lucio-barbieri/ASIC-BOB/README.md

# ASIC-BOB

Break-out board for the RFID+ ASIC.

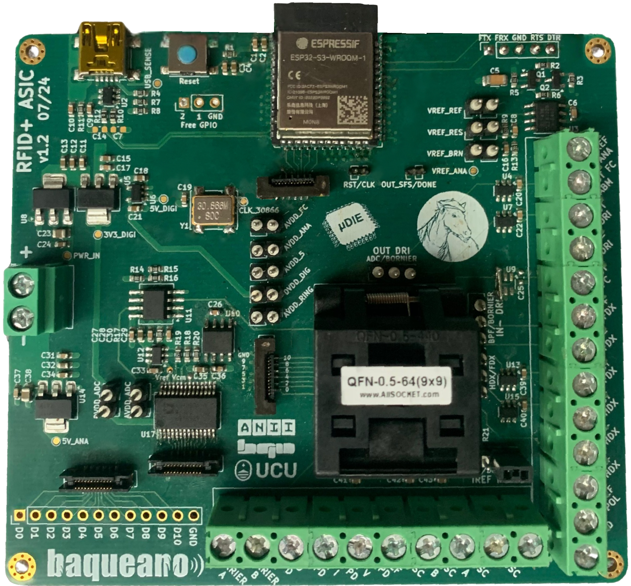
[picture p1: asic_bob.png]
ASIC BOB


---
