lucio-barbieri/ASIC-BOB/manufacturing/bom.csv

Designator | Footprint | Quantity | Value | LCSC Part #
C1, C12, C13, C15, C32, C34, C35 | 0603 | 7 | 10u
C10, C11, C16, C17, C19, C2, C20, C22, C24, C25, C26, C27, C29, C3, C30, C31, C33, C36, C37, C39, C40, C41, C42, C43, C6, C8, C9 | 0603 | 27 | 100n
C18, C21, C28, C4 | 0603 | 4 | 1u
C23, C38 | 0805 | 2 | 47u
C5 | 1206 | 1 | 10u
J10 | 117347422 | 1 | ADC side
J11 | 117347422 | 1 | User side
J12 | TerminalBlock_Phoenix_MKDS-1,5-10-5.08_1x10_P5.08mm_Horizontal | 1 | Outside interface
J13 | PinHeader_1x12_P2.54mm_Vertical | 1 | User side pinout
J2 | USB_Mini-B_Lumberg_2486_01_Horizontal | 1 | USB_B_Mini
J4 | PinHeader_1x02_P1.27mm_Vertical | 1 | OUT_SFS/DONE
J5 | PinHeader_1x02_P1.27mm_Vertical | 1 | RST/CLK
J6 | 117347422 | 1 | MCU side
J7 | TerminalBlock_Phoenix_MKDS-1,5-2_1x02_P5.00mm_Horizontal | 1 | Batt
J8 | TerminalBlock_Phoenix_MKDS-1,5-13-5.08_1x13_P5.08mm_Horizontal | 1 | Outside interface
J9 | 117347422 | 1 | ASIC side
Q1, Q2 | SOT-23 | 2 | 2SK2158
R1, R2, R3, R4, R5, R6, R7, R8 | 0603 | 8 | 10k
R10, R12 | 0603 | 2 | 0R
R11 | 0603 | 1 | 10
R13, R9 | 0603 | 2 | 220
R14, R15, R17, R18, R20 | 0603 | 5 | 1k
R16 | 0603 | 1 | 2k
R19 | 0603 | 1 | 1.5k
SW1 | SW_Push_1P1T_NO_6x6mm_H9.5mm | 1 | Reset
U1 | ESP32-S3-WROOM-1 | 1 | ESP32-S3-WROOM-1
U10, U3 | SOIC-8_3.9x4.9mm_P1.27mm | 2 | REF43
U11 | SO-8_5.3x6.2mm_P1.27mm | 1 | LT6231,
U12, U13, U15, U18, U19, U20, U4, U7, U9 | TSOT-23-6 | 9 | LT6230xS6
U14, U8 | SOT-223-3_TabPin2 | 2 | AMS1117-5.0
U17 | SSOP-28_5.3x10.2mm_P0.65mm | 1 | AD9200
U2 | SOT-23-6 | 1 | USBLC6-2SC6
U5 | SOT-223-3_TabPin2 | 1 | AMS1117-3.3
U6 | SOT-23-5 | 1 | MIC5504-1.8YM5
