lucio-barbieri/ASIC-BOB/manufacturing/JLCSMT_BOM.xlsx

Designator | Footprint | Quantity | Comment | LCSC Part # (optional)
C1, C12, C13, C15, C32, C34, C35 | 0603 | 7 | 10u | C19702
C10, C11, C16, C17, C19, C2, C20, C22, C24, C25, C26, C27, C29, C3, C30, C31, C33, C36, C37, C39, C40, C41, C42, C43, C6, C8, C9 | 0603 | 27 | 100n | C14663
C18, C21, C28, C4 | 0603 | 4 | 1u | C108463
C23, C38 | 0805 | 2 | 47u | C108659
C5 | 1206 | 1 | 10u | C13585
J12 | TerminalBlock_Phoenix_MKDS-1,5-10-5.08_1x10_P5.08mm_Horizontal | 1 | Outside interface
J2 | USB_Mini-B_Lumberg_2486_01_Horizontal | 1 | USB_B_Mini | C2681563
J4, J5 | PinHeader_1x02_P1.27mm_Vertical | 2 | OUT_SFS/DONE, RST/CLK | C2881948
J6, J9, J10, J11 | 117347422 | 4 | MCU side, ASIC side, ADC side, User side | C590853
J7 | TerminalBlock_Phoenix_MKDS-1,5-2_1x02_P5.00mm_Horizontal | 1 | Batt | C8404
J8 | TerminalBlock_Phoenix_MKDS-1,5-13-5.08_1x13_P5.08mm_Horizontal | 1 | Outside interface
Q1, Q2 | SOT-23 | 2 | 2SK2158 | C130894
R1, R2, R3, R4, R5, R6, R7, R8 | 0603 | 8 | 10k | C25804
R10, R12 | 0603 | 2 | 0R | C21189
R11 | 0603 | 1 | 10 | C22859
R13, R9 | 0603 | 2 | 220 | C22962
R14, R15, R17, R18, R20 | 0603 | 5 | 1k | C21190
R16 | 0603 | 1 | 2k | C22975
R19 | 0603 | 1 | 1.5k | C101276
SW1 | SW_Push_1P1T_NO_6x6mm_H9.5mm | 1 | Reset | C285446
U1 | ESP32-S3-WROOM-1 | 1 | ESP32-S3-WROOM-1 | C2913199
U10, U3 | SOIC-8_3.9x4.9mm_P1.27mm | 2 | REF43
U11 | SO-8_5.3x6.2mm_P1.27mm | 1 | LT6231 | C580237
U12, U13, U15, U18, U19, U20, U4, U7, U9 | TSOT-23-6 | 9 | LT6230xS6 | C580235
U14, U8 | SOT-223-3_TabPin2 | 2 | AMS1117-5.0 | C6187
U17 | SSOP-28_5.3x10.2mm_P0.65mm | 1 | AD9200 | C207693
U2 | SOT-23-6 | 1 | USBLC6-2SC6 | C2827654
U5 | SOT-223-3_TabPin2 | 1 | AMS1117-3.3 | C347222
U6 | SOT-23-5 | 1 | MIC5504-1.8YM5 | C626116
