lucio-barbieri/ASIC-BOB/socket.step

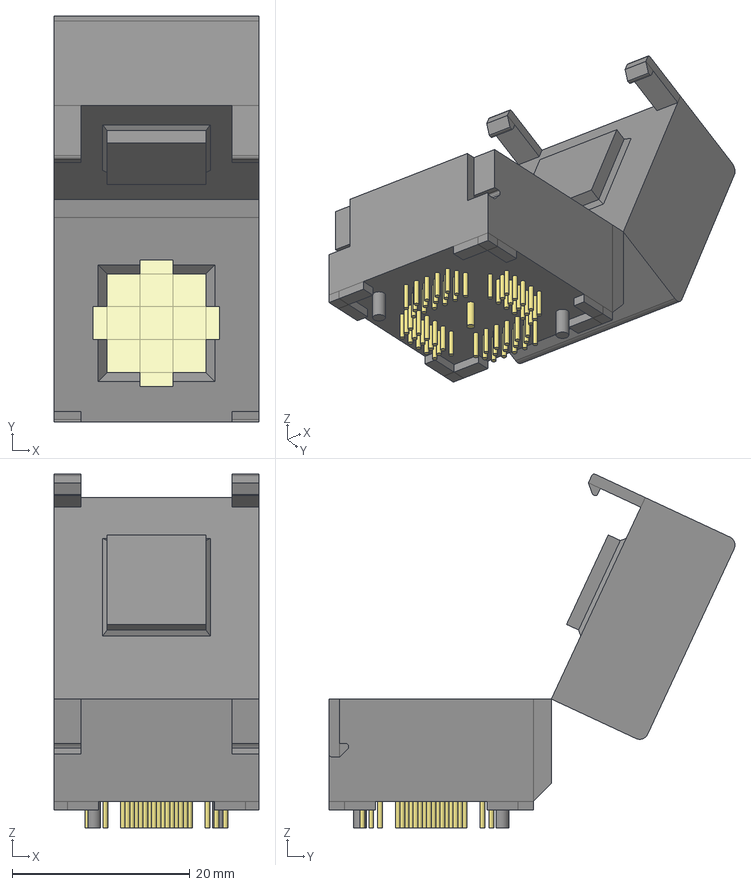
[picture p2: CAD file, 2024-06-28]
socket.step
23.0 x 45.7 x 39.8 mm
