lucio-barbieri/ASIC-BOB/(list of files, cad)

Other CAD files:
socket.FCStd
