lucio-barbieri/ASIC-BOB/asicBOB.kicad_pcb

## KiCad design asicBOB.kicad_pcb (2026-11-03)

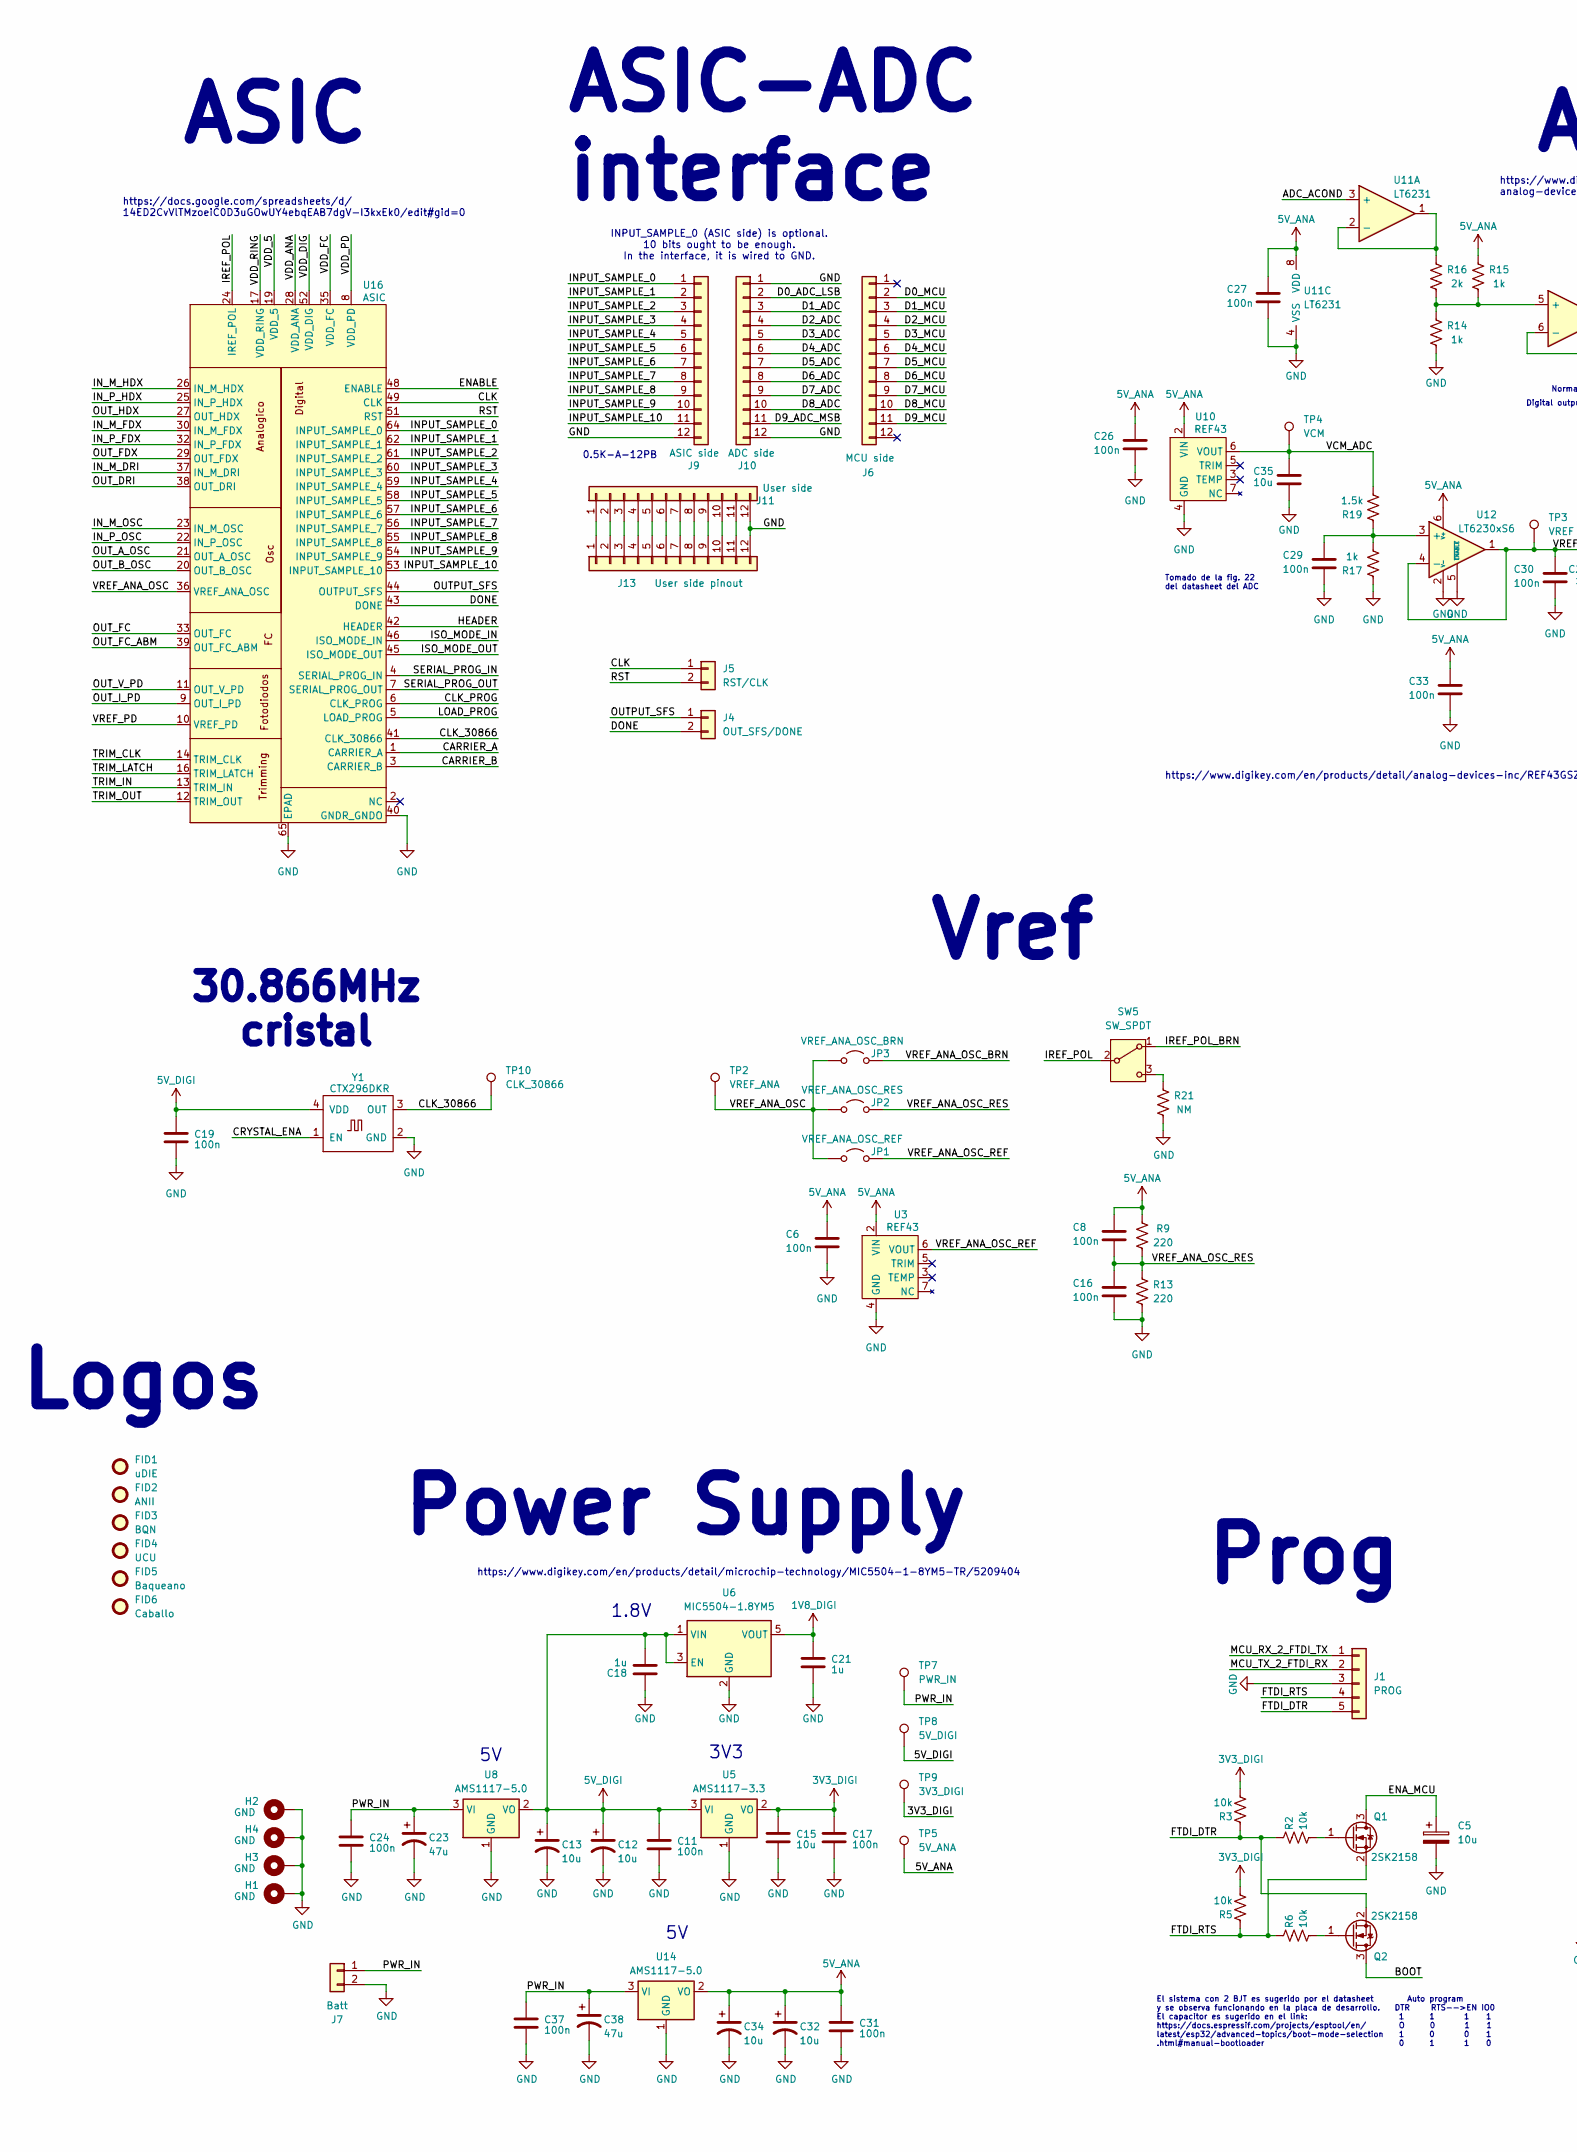
[picture p3: schematic asicBOB.kicad_sch, ASIC_BOB, part in row 1, column 1]

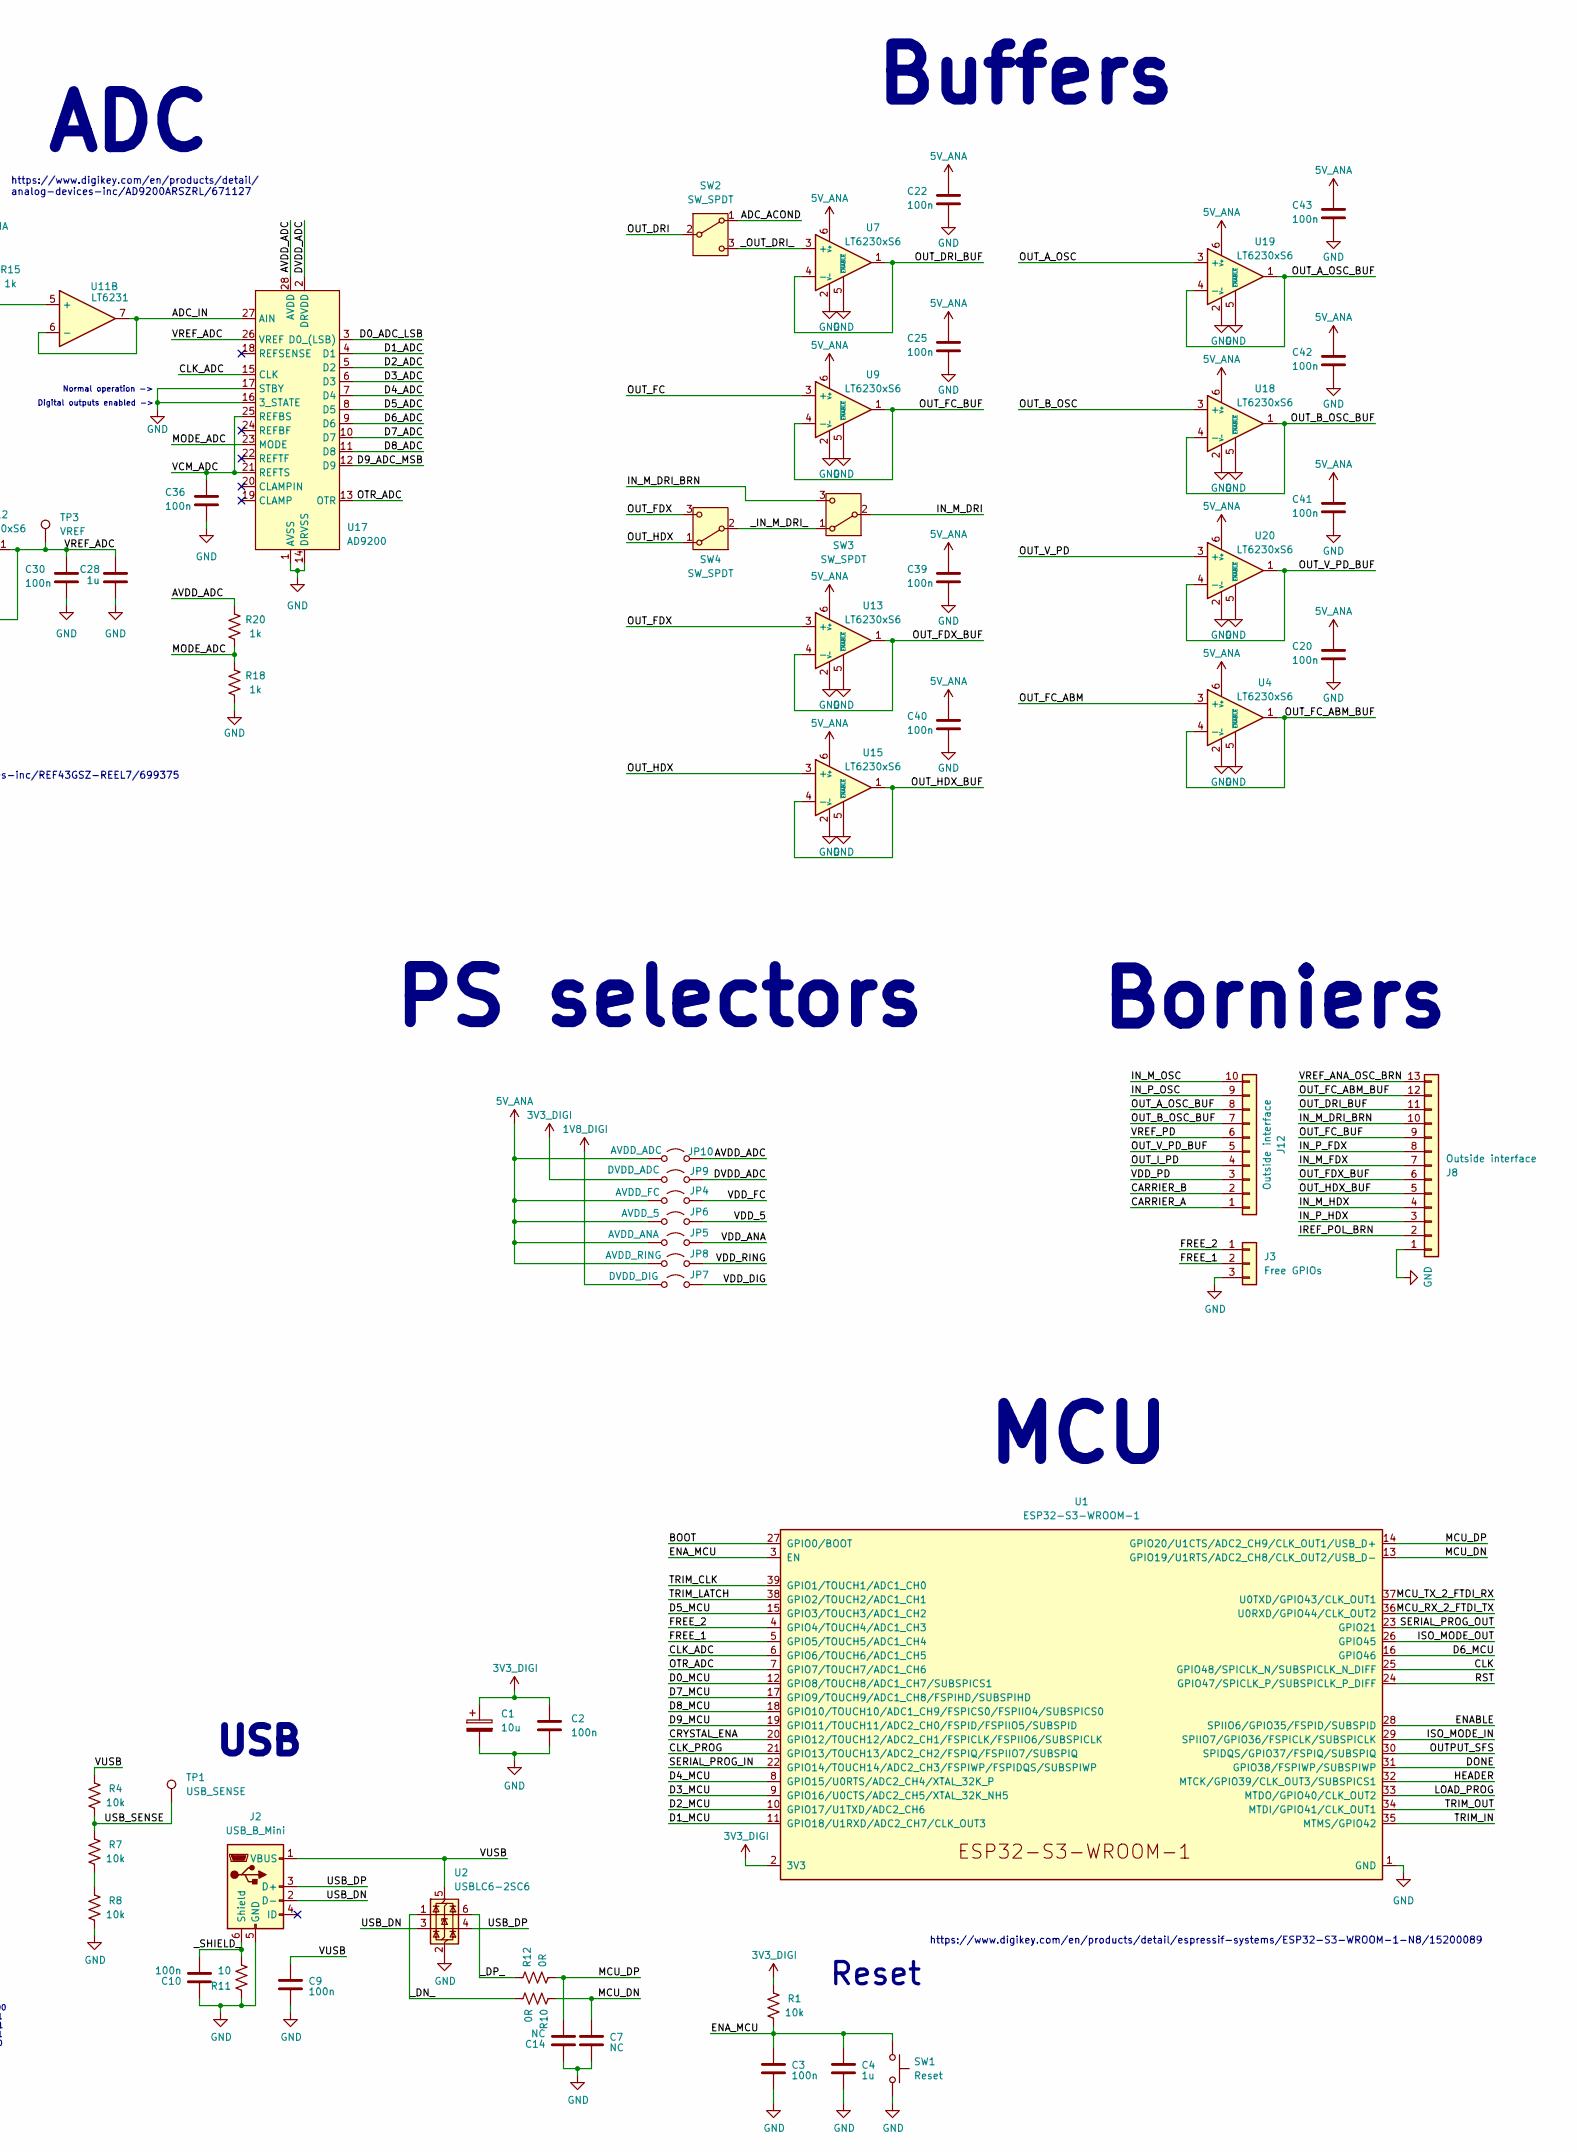
[picture p4: schematic asicBOB.kicad_sch, ASIC_BOB, part in row 1, column 2]

Parts:
C1, C12, C13, C15, C32, C34, C35: 10u; C_0603_1608Metric
C2, C3, C6, C8, C9, C10, C11, C16, C17, C19, C20, C22, C24, C25, C26, C27, C29, C30, C31, C33, C36, C37, C39, C40, C41, C42, C43: 100n; C_0603_1608Metric
C4, C18, C21, C28: 1u; C_0603_1608Metric
C5: 10u; C_1206_3216Metric
C7, C14: NC; C_0603_1608Metric
C23, C38: 47u; C_0805_2012Metric
FID1: uDIE; Logo_uDIE
FID2: ANII; Logo_ANII
FID3: BQN; Logo_BQN_12x4
FID4: UCU; Logo_UCU
FID5: Baqueano; Logo_baqueano_5x25
FID6: Caballo; Logo_caballoConBoina_15mm
H1, H2, H3, H4: GND; MountingHole_2.2mm_M2_Pad_Via
J1: PROG; PinSocket_1x05_P2.54mm_Vertical
J2: USB_B_Mini; USB_Mini-B_Lumberg_2486_01_Horizontal
J3: Free GPIOs; PinHeader_1x03_P2.54mm_Vertical
J4: OUT_SFS/DONE; PinHeader_1x02_P1.27mm_Vertical
J5: RST/CLK; PinHeader_1x02_P1.27mm_Vertical
J6: MCU side; 117347422
J7: Batt; TerminalBlock_Phoenix_MKDS-1,5-2_1x02_P5.00mm_Horizontal
J8: Outside interface; TerminalBlock_Phoenix_MKDS-1,5-13-5.08_1x13_P5.08mm_Horizon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
J9: ASIC side; 117347422
J10: ADC side; 117347422
J11: User side; 117347422
J12: Outside interface; TerminalBlock_Phoenix_MKDS-1,5-10-5.08_1x10_P5.08mm_Horizon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
J13: User side pinout; PinHeader_1x12_P2.54mm_Vertical
JP1: VREF_ANA_OSC_REF; PinHeader_1x02_P2.54mm_Vertical
JP2: VREF_ANA_OSC_RES; PinHeader_1x02_P2.54mm_Vertical
JP3: VREF_ANA_OSC_BRN; PinHeader_1x02_P2.54mm_Vertical
JP4: AVDD_FC; PinHeader_1x02_P2.54mm_Vertical
JP5: AVDD_ANA; PinHeader_1x02_P2.54mm_Vertical
JP6: AVDD_5; PinHeader_1x02_P2.54mm_Vertical
JP7: DVDD_DIG; PinHeader_1x02_P2.54mm_Vertical
JP8: AVDD_RING; PinHeader_1x02_P2.54mm_Vertical
JP9: DVDD_ADC; PinHeader_1x02_P2.54mm_Vertical
JP10: AVDD_ADC; PinHeader_1x02_P2.54mm_Vertical
Q1, Q2: 2SK2158; SOT-23
R1, R2, R3, R4, R5, R6, R7, R8: 10k; R_0603_1608Metric
R9, R13: 220; R_0603_1608Metric
R10, R12: 0R; R_0603_1608Metric
R11: 10; R_0603_1608Metric
R14, R15, R17, R18, R20: 1k; R_0603_1608Metric
R16: 2k; R_0603_1608Metric
R19: 1.5k; R_0603_1608Metric
R21: NM; R_0603_1608Metric
SW1: Reset; SW_Push_1P1T_NO_6x6mm_H9.5mm
SW2, SW3, SW4, SW5: SW_SPDT; PinHeader_1x03_P2.54mm_Vertical
TP1: USB_SENSE; TestPoint_Pad_D1.0mm
TP2: VREF_ANA; TestPoint_Pad_D1.0mm
TP3: VREF; TestPoint_Pad_D1.0mm
TP4: VCM; TestPoint_Pad_D1.0mm
TP5: 5V_ANA; TestPoint_Pad_D1.0mm
TP7: PWR_IN; TestPoint_Pad_D1.0mm
TP8: 5V_DIGI; TestPoint_Pad_D1.0mm
TP9: 3V3_DIGI; TestPoint_Pad_D1.0mm
TP10: CLK_30866; TestPoint_Pad_D1.0mm
U1: ESP32-S3-WROOM-1
U2: USBLC6-2SC6; SOT-23-6
U3, U10: REF43; SOIC-8_3.9x4.9mm_P1.27mm
U4, U7, U9, U12, U13, U15, U18, U19, U20: LT6230xS6; TSOT-23-6
U5: AMS1117-3.3; SOT-223-3_TabPin2
U6: MIC5504-1.8YM5; SOT-23-5
U8, U14: AMS1117-5.0; SOT-223-3_TabPin2
U11: LT6231; SO-8_5.3x6.2mm_P1.27mm
U16: ASIC; ASIC_RFID
U17: AD9200; SSOP-28_5.3x10.2mm_P0.65mm
Y1: CTX296DKR

Connections:
1V8_DIGI: C21.1, JP7.2 (B), U6.5 (VOUT)
3V3_DIGI: C1.1, C2.1, C15.1, C17.1, JP9.2 (B), R1.2, R3.2, R5.2, TP9.1, U1.2 (3V3), U5.2 (VO)
5V_ANA: C6.2, C8.2, C20.2, C22.2, C25.2, C26.2, C27.2, C31.1, C32.1, C33.2, C34.1, C39.2, C40.2, C41.2, C42.2, C43.2, JP4.2 (B), JP5.2 (B), JP6.2 (B), JP8.2 (B), JP10.1 (A), R9.2, R15.2, TP5.1, U3.2 (VIN), U4.6 (V+), U7.6 (V+), U9.6 (V+), U10.2 (VIN), U11.8 (VDD), U12.6 (V+), U13.6 (V+), U14.2 (VO), U15.6 (V+), U18.6 (V+), U19.6 (V+), U20.6 (V+)
5V_DIGI: C11.1, C12.1, C13.1, C18.2, C19.1, TP8.1, U5.3 (VI), U6.1 (VIN), U6.3 (EN), U8.2 (VO), Y1.4 (VDD)
/ADC_ACOND: SW2.1 (A), U11.3 (+)
/ADC_IN: U11.6 (-), U11.7, U17.27 (AIN)
/AVDD_ADC: JP10.2 (B), R20.2, U17.28 (AVDD)
/BOOT: Q2.3 (D), U1.27 (GPIO0/BOOT)
/CARRIER_A: J12.1, U16.1 (CARRIER_A)
/CARRIER_B: J12.2, U16.3 (CARRIER_B)
/CLK: J5.1, U1.25 (GPIO48/SPICLK_N/SUBSPICLK_N_DIFF), U16.49 (CLK)
/CLK_30866: TP10.1, U16.41 (CLK_30866), Y1.3 (OUT)
/CLK_ADC: U1.6 (GPIO6/TOUCH6/ADC1_CH5), U17.15 (CLK)
/CLK_PROG: U1.21 (GPIO13/TOUCH13/ADC2_CH2/FSPIQ/FSPIIO7/S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), U16.6 (CLK_PROG)
/CRYSTAL_ENA: U1.20 (GPIO12/TOUCH12/ADC2_CH1/FSPICLK/FSPIIO6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), Y1.1 (EN)
/D0_ADC_LSB: J10.2, U17.3 (D0_(LSB))
/D0_MCU: J6.2, U1.12 (GPIO8/TOUCH8/ADC1_CH7/SUBSPICS1)
/D1_ADC: J10.3, U17.4 (D1)
/D1_MCU: J6.3, U1.11 (GPIO18/U1RXD/ADC2_CH7/CLK_OUT3)
/D2_ADC: J10.4, U17.5 (D2)
/D2_MCU: J6.4, U1.10 (GPIO17/U1TXD/ADC2_CH6)
/D3_ADC: J10.5, U17.6 (D3)
/D3_MCU: J6.5, U1.9 (GPIO16/U0CTS/ADC2_CH5/XTAL_32K_NH5)
/D4_ADC: J10.6, U17.7 (D4)
/D4_MCU: J6.6, U1.8 (GPIO15/U0RTS/ADC2_CH4/XTAL_32K_P)
/D5_ADC: J10.7, U17.8 (D5)
/D5_MCU: J6.7, U1.15 (GPIO3/TOUCH3/ADC1_CH2)
/D6_ADC: J10.8, U17.9 (D6)
/D6_MCU: J6.8, U1.16 (GPIO46)
/D7_ADC: J10.9, U17.10 (D7)
/D7_MCU: J6.9, U1.17 (GPIO9/TOUCH9/ADC1_CH8/FSPIHD/SUBSPIHD)
/D8_ADC: J10.10, U17.11 (D8)
/D8_MCU: J6.10, U1.18 (GPIO10/TOUCH10/ADC1_CH9/FSPICS0/FSPIIO4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)
/D9_ADC_MSB: J10.11, U17.12 (D9)
/D9_MCU: J6.11, U1.19 (GPIO11/TOUCH11/ADC2_CH0/FSPID/FSPIIO5/S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)
/DONE: J4.2, U1.31 (GPIO38/FSPIWP/SUBSPIWP), U16.43 (DONE)
/DVDD_ADC: JP9.1 (A), U17.2 (DRVDD)
/ENABLE: U1.28 (SPIIO6/GPIO35/FSPID/SUBSPID), U16.48 (ENABLE)
/ENA_MCU: C3.1, C4.1, C5.1, Q1.3 (D), R1.1, SW1.1, U1.3 (EN)
/FREE_1: J3.2, U1.5 (GPIO5/TOUCH5/ADC1_CH4)
/FREE_2: J3.1, U1.4 (GPIO4/TOUCH4/ADC1_CH3)
/FTDI_DTR: J1.5, Q2.2 (S), R2.1, R3.1
/FTDI_RTS: J1.4, Q1.2 (S), R5.1, R6.1
/HEADER: U1.32 (MTCK/GPIO39/CLK_OUT3/SUBSPICS1), U16.42 (HEADER)
/INPUT_SAMPLE_0: J9.1, U16.64 (INPUT_SAMPLE_0)
/INPUT_SAMPLE_1: J9.2, U16.62 (INPUT_SAMPLE_1)
/INPUT_SAMPLE_2: J9.3, U16.61 (INPUT_SAMPLE_2)
/INPUT_SAMPLE_3: J9.4, U16.60 (INPUT_SAMPLE_3)
/INPUT_SAMPLE_4: J9.5, U16.59 (INPUT_SAMPLE_4)
/INPUT_SAMPLE_5: J9.6, U16.58 (INPUT_SAMPLE_5)
/INPUT_SAMPLE_6: J9.7, U16.57 (INPUT_SAMPLE_6)
/INPUT_SAMPLE_7: J9.8, U16.56 (INPUT_SAMPLE_7)
/INPUT_SAMPLE_8: J9.9, U16.55 (INPUT_SAMPLE_8)
/INPUT_SAMPLE_9: J9.10, U16.54 (INPUT_SAMPLE_9)
/INPUT_SAMPLE_10: J9.11, U16.53 (INPUT_SAMPLE_10)
/IN_M_DRI: SW3.2 (B), U16.37 (IN_M_DRI)
/IN_M_DRI_BRN: J8.10, SW3.3 (C)
/IN_M_FDX: J8.7, U16.30 (IN_M_FDX)
/IN_M_HDX: J8.4, U16.26 (IN_M_HDX)
/IN_M_OSC: J12.10, U16.23 (IN_M_OSC)
/IN_P_FDX: J8.8, U16.32 (IN_P_FDX)
/IN_P_HDX: J8.3, U16.25 (IN_P_HDX)
/IN_P_OSC: J12.9, U16.22 (IN_P_OSC)
/IREF_POL: SW5.2 (B), U16.24 (IREF_POL)
/IREF_POL_BRN: J8.2, SW5.1 (A)
/ISO_MODE_IN: U1.29 (SPIIO7/GPIO36/FSPICLK/SUBSPICLK), U16.46 (ISO_MODE_IN)
/ISO_MODE_OUT: U1.26 (GPIO45), U16.45 (ISO_MODE_OUT)
/LOAD_PROG: U1.33 (MTDO/GPIO40/CLK_OUT2), U16.5 (LOAD_PROG)
/MCU_DN: C7.1, R10.1, U1.13 (GPIO19/U1RTS/ADC2_CH8/CLK_OUT2/USB_D-)
/MCU_DP: C14.2, R12.2, U1.14 (GPIO20/U1CTS/ADC2_CH9/CLK_OUT1/USB_D+)
/MCU_RX_2_FTDI_TX: J1.1, U1.36 (U0RXD/GPIO44/CLK_OUT2)
/MCU_TX_2_FTDI_RX: J1.2, U1.37 (U0TXD/GPIO43/CLK_OUT1)
/MODE_ADC: R18.2, R20.1, U17.23 (MODE)
/OTR_ADC: U1.7 (GPIO7/TOUCH7/ADC1_CH6), U17.13 (OTR)
/OUTPUT_SFS: J4.1, U1.30 (SPIDQS/GPIO37/FSPIQ/SUBSPIQ), U16.44 (OUTPUT_SFS)
/OUT_A_OSC: U16.21 (OUT_A_OSC), U19.3 (+)
/OUT_A_OSC_BUF: J12.8, U19.1, U19.4 (-)
/OUT_B_OSC: U16.20 (OUT_B_OSC), U18.3 (+)
/OUT_B_OSC_BUF: J12.7, U18.1, U18.4 (-)
/OUT_DRI: SW2.2 (B), U16.38 (OUT_DRI)
/OUT_DRI_BUF: J8.11, U7.1, U7.4 (-)
/OUT_FC: U9.3 (+), U16.33 (OUT_FC)
/OUT_FC_ABM: U4.3 (+), U16.39 (OUT_FC_ABM)
/OUT_FC_ABM_BUF: J8.12, U4.1, U4.4 (-)
/OUT_FC_BUF: J8.9, U9.1, U9.4 (-)
/OUT_FDX: SW4.3 (C), U13.3 (+), U16.29 (OUT_FDX)
/OUT_FDX_BUF: J8.6, U13.1, U13.4 (-)
/OUT_HDX: SW4.1 (A), U15.3 (+), U16.27 (OUT_HDX)
/OUT_HDX_BUF: J8.5, U15.1, U15.4 (-)
/OUT_I_PD: J12.4, U16.9 (OUT_I_PD)
/OUT_V_PD: U16.11 (OUT_V_PD), U20.3 (+)
/OUT_V_PD_BUF: J12.5, U20.1, U20.4 (-)
/PWR_IN: C23.1, C24.1, C37.1, C38.1, J7.1, TP7.1, U8.3 (VI), U14.3 (VI)
/RST: J5.2, U1.24 (GPIO47/SPICLK_P/SUBSPICLK_P_DIFF), U16.51 (RST)
/SERIAL_PROG_IN: U1.22 (GPIO14/TOUCH14/ADC2_CH3/FSPIWP/FSPIDQS/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), U16.4 (SERIAL_PROG_IN)
/SERIAL_PROG_OUT: U1.23 (GPIO21), U16.7 (SERIAL_PROG_OUT)
/TRIM_CLK: U1.39 (GPIO1/TOUCH1/ADC1_CH0), U16.14 (TRIM_CLK)
/TRIM_IN: U1.35 (MTMS/GPIO42), U16.13 (TRIM_IN)
/TRIM_LATCH: U1.38 (GPIO2/TOUCH2/ADC1_CH1), U16.16 (TRIM_LATCH)
/TRIM_OUT: U1.34 (MTDI/GPIO41/CLK_OUT1), U16.12 (TRIM_OUT)
/USB_DN: J2.2 (D-), U2.3 (I/O2)
/USB_DP: J2.3 (D+), U2.4 (I/O2)
/USB_SENSE: R4.1, R7.2, TP1.1
/VCM_ADC: C35.2, C36.2, R19.1, TP4.1, U10.6 (VOUT), U17.21 (REFTS), U17.25 (REFBS)
/VDD_5: JP6.1 (A), U16.19 (VDD_5)
/VDD_ANA: JP5.1 (A), U16.28 (VDD_ANA)
/VDD_DIG: JP7.1 (A), U16.52 (VDD_DIG)
/VDD_FC: JP4.1 (A), U16.35 (VDD_FC)
/VDD_PD: J12.3, U16.8 (VDD_PD)
/VDD_RING: JP8.1 (A), U16.17 (VDD_RING)
/VREF_ADC: C28.2, C30.2, TP3.1, U12.1, U12.4 (-), U17.26 (VREF)
/VREF_ANA_OSC: JP1.1 (A), JP2.1 (A), JP3.1 (A), TP2.1, U16.36 (VREF_ANA_OSC)
/VREF_ANA_OSC_BRN: J8.13, JP3.2 (B)
/VREF_ANA_OSC_REF: JP1.2 (B), U3.6 (VOUT)
/VREF_ANA_OSC_RES: C8.1, C16.2, JP2.2 (B), R9.1, R13.2
/VREF_PD: J12.6, U16.10 (VREF_PD)
/VUSB: C9.1, J2.1 (VBUS), R4.2, U2.5 (VBUS)
/_DN_: R10.2, U2.1 (I/O1)
/_DP_: R12.1, U2.6 (I/O1)
/_IN_M_DRI_: SW3.1 (A), SW4.2 (B)
/_OUT_DRI_: SW2.3 (C), U7.3 (+)
/_SHIELD_: C10.2, J2.6 (Shield), R11.2
GND: C1.2, C2.2, C3.2, C4.2, C5.2, C6.1, C7.2, C9.2, C10.1, C11.2, C12.2, C13.2, C14.1, C15.2, C16.1, C17.2, C18.1, C19.2, C20.1, C21.2, C22.1, C23.2, C24.2, C25.1, C26.1, C27.1, C28.1, C29.1, C30.1, C31.2, C32.2, C33.1, C34.2, C35.1, C36.1, C37.2, C38.2, C39.1, C40.1, C41.1, C42.1, C43.1, H1.1, H2.1, H3.1, H4.1, J1.3, J2.5 (GND), J3.3, J7.2, J8.1, J9.12, J10.1, J10.12, J11.12, J13.12, R8.1, R11.1, R13.1, R14.1, R17.2, R18.1, R21.1, SW1.2, U1.1 (GND), U1.40 (GND), U1.41 (GND), U2.2 (GND), U3.4 (GND), U4.2 (V-), U4.5 (~ENABLE), U5.1 (GND), U6.2 (GND), U7.2 (V-), U7.5 (~ENABLE), U8.1 (GND), U9.2 (V-), U9.5 (~ENABLE), U10.4 (GND), U11.4 (VSS), U12.2 (V-), U12.5 (~ENABLE), U13.2 (V-), U13.5 (~ENABLE), U14.1 (GND), U15.2 (V-), U15.5 (~ENABLE), U16.40 (GNDR_GNDO), U16.65 (EPAD), U17.1 (AVSS), U17.14 (DRVSS), U17.16 (3_STATE), U17.17 (STBY), U18.2 (V-), U18.5 (~ENABLE), U19.2 (V-), U19.5 (~ENABLE), U20.2 (V-), U20.5 (~ENABLE), Y1.2 (GND)
unnamed: J11.1, J13.1
unnamed: J11.2, J13.2
unnamed: J11.3, J13.3
unnamed: J11.4, J13.4
unnamed: J11.5, J13.5
unnamed: J11.6, J13.6
unnamed: J11.7, J13.7
unnamed: J11.8, J13.8
unnamed: J11.9, J13.9
unnamed: J11.10, J13.10
unnamed: J11.11, J13.11
unnamed: Q1.1 (G), R2.2
unnamed: Q2.1 (G), R6.2
unnamed: R7.1, R8.2
unnamed: R21.2, SW5.3 (C)
unnamed: R16.2, U11.1, U11.2 (-)
unnamed: R14.2, R15.1, R16.1, U11.5 (+)
unnamed: C29.2, R17.1, R19.2, U12.3 (+)

Notes on the sheet:
0.5K-A-12PB
Logos
INPUT_SAMPLE_0 (ASIC side) is optional. 10 bits ought to be enough. In the interface, it is wired to GND.
ADC
ASIC-ADC interface
3V3
https://www.digikey.com/en/products/detail/analog-devices-inc/REF43GSZ-REEL7/699375
https://www.digikey.com/en/products/detail/microchip-technology/MIC5504-1-8YM5-TR/5209404
USB
https://www.digikey.com/en/products/detail/espressif-systems/ESP32-S3-WROOM-1-N8/15200089
Auto program DTR RTS-->EN IO0 1 1 1 1 O 0 1 1 1 0 0 1 0 1 1 0
ASIC
Tomado de la fig. 22 del datasheet del ADC
Reset
Prog
Power Supply
El sistema con 2 BJT es sugerido por el datasheet y se observa funcionando en la placa de desarrollo. El capacitor es sugerido en el link: https://docs.espressif.com/projects/esptool/en/ latest/esp32/advanced-topics/boot-mode-selection .html#manual-bootloader
https://www.digikey.com/en/products/detail/ analog-devices-inc/AD9200ARSZRL/671127
https://docs.google.com/spreadsheets/d/ 14ED2CvVlTMzoeiC0D3uGOwUY4ebqEAB7dgV-I3kxEk0/edit#gid=0
Buffers
Vref
1.8V
PS selectors
30.866MHz cristal
Normal operation ->
Digital outputs enabled ->
MCU
Borniers

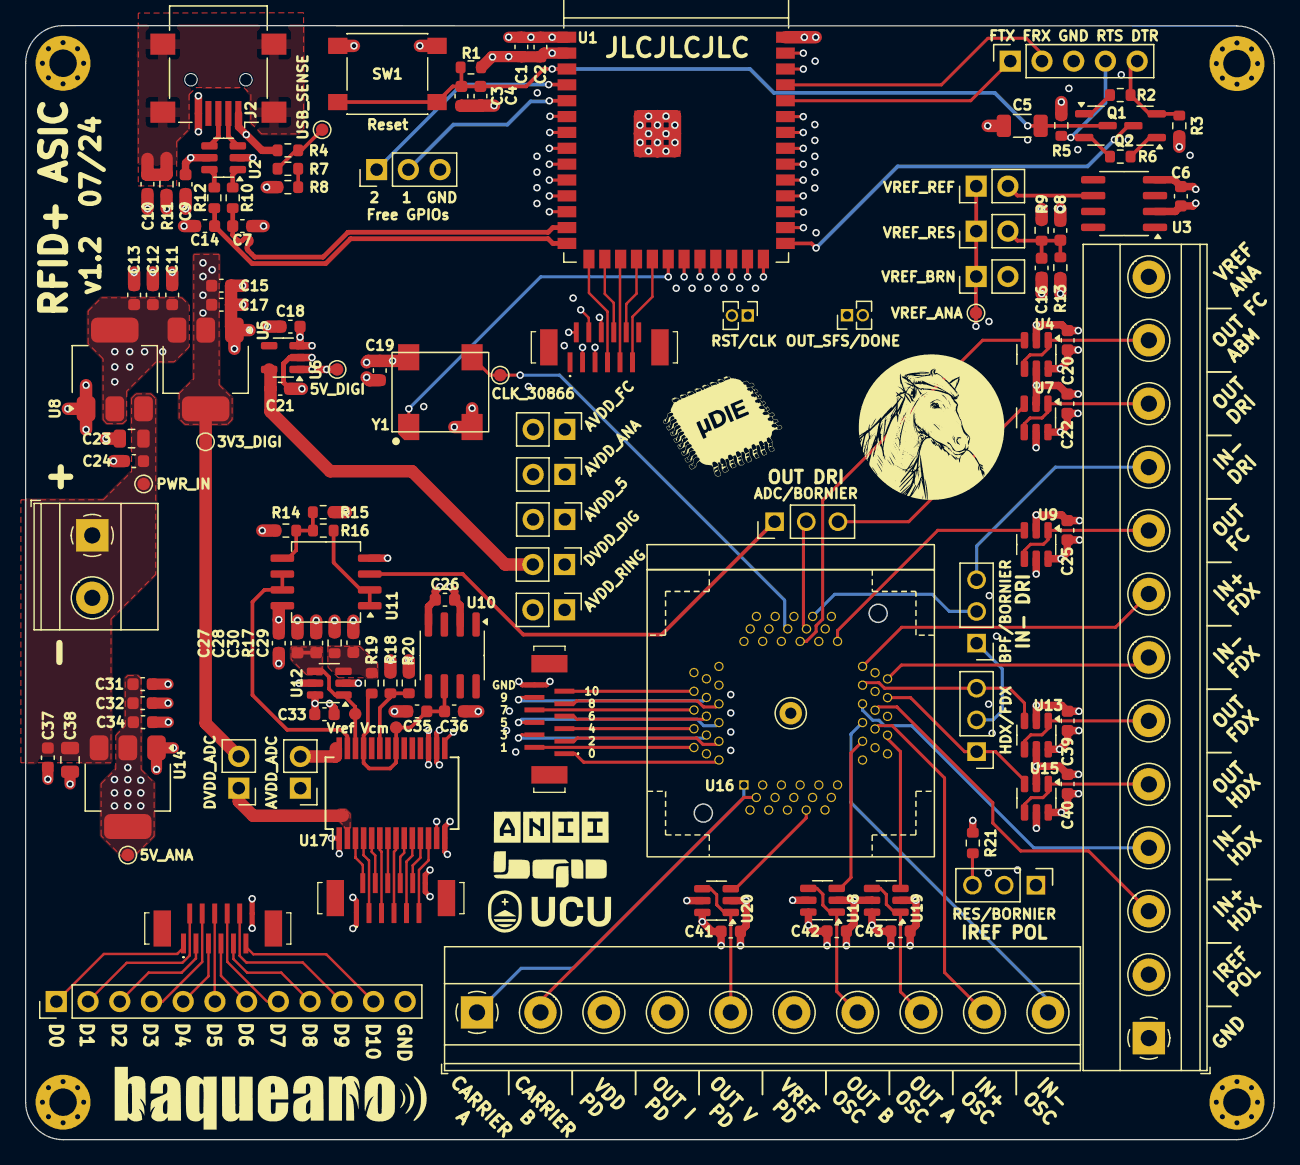
[picture p5: board asicBOB.kicad_pcb from above]

Board: 6 copper layers, 100.0 x 89.2 mm, 134 parts (0 on the bottom side), 141 nets.
