lucio-barbieri/ASIC-BOB/(commit log)

2024-06-28 Version casi completa, con USB, sin UART.
    [asicBOB-B_Cu_SIG.gbr, asicBOB-B_Mask.gbr, asicBOB-B_Paste.gbr, asicBOB-B_Silkscreen.gbr, asicBOB-Edge_Cuts.gbr, asicBOB-F_Cu_SIG.gbr, asicBOB-F_Mask.gbr, asicBOB-F_Paste.gbr]
2024-06-28 Version con dos USBs, uno con FTDI y otro USB mismo.
    [asicBOB.kicad_pcb, asicBOB.kicad_sch]
2024-06-28 Agrego pinout para FTDI BOB
    [asicBOB.kicad_pcb, asicBOB.kicad_sch]
2024-07-11 Agrego programacion.
    [asicBOB.kicad_pcb, asicBOB.kicad_sch]
2026-07-16 Cosas modificadas, revisar.
    [JLCSMT_BOM.xlsx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]
2026-11-03 Actualizado a KiCAD 10. Repo publico.
    [asicBOB.kicad_pcb, asicBOB.kicad_sch]
